ddeliakidis/final-project-whear/README.md

Review Assignment Due Date (https://classroom.github.com/a/-Acvnhrq)

# Final Project

**Team Number:** 4

**Team Name:** Whear

| Team Member Name | Email Address |
| --- | --- |
| jefferson ding | tyding@seas.upenn.edu |
| dimitris deliakidis | ddelias@seas.upenn.edu  |
| carly googel | cagoogel@seas.upenn.edu |

**GitHub Repository URL:** https://github.com/upenn-embedded/final-project-whear

**iOS App Repository:** https://github.com/carlygoogel/Whear

**GitHub Pages Website URL:** [for final submission]\*

## Final Project Proposal

### 1. Abstract

Whear is a smart closet inventory system that tracks which garments are present in your wardrobe in real time. Washable UHF RFID laundry tags are sewn or stuck onto each item, and a YRM100 (Impinj R2000) reader sweeps the closet over a 5–6 dBi UHF patch antenna with a 3–6 m range. The reader is driven by a bare-metal STM32F411RE (Nucleo-64) over UART, which maintains a live presence table with per-tag TTL. On each sweep interval the STM32 framepacks the current tag set over a second UART to an ESP32 Feather HUZZAH32 V2 Wi-Fi bridge, which reconciles the set against a Firestore collection (PATCH for current tags, DELETE for stale ones). A companion iOS app reads the same collection and shows garments as present / missing in real time.

### 2. Motivation

Getting ready shouldn’t be stressful, and yet most people routinely can’t find the garment they want, don’t know whether an item is in the closet, the laundry, or simply misplaced, forget about clothes they haven’t worn in weeks, and end up buying duplicates of pieces they already own. Whear fixes this by making the closet itself aware of its contents: every garment is tagged, the reader continuously reconciles presence/absence, and the app surfaces pieces that have gone missing or haven’t been worn in a long time. The problem is a good fit for an embedded system — it needs always-on scanning, a real UHF RF front end, strict timing for the RFID framing protocol, and a networked bridge to a phone.

### 3. System Block Diagram

```
 ┌─────────────────┐           ┌──────────────────────────────────────────┐
 │ RFID tags on    │  UHF      │ UHF patch antenna (5–6 dBi, SMA)         │
 │ each garment    │◄────────►│                                          │
 │ (96-bit EPC)    │           └────────────────┬─────────────────────────┘
 └─────────────────┘                            │
                                                ▼
                                  ┌──────────────────────┐
                                  │ YRM100 RFID reader   │
                                  │ (Impinj R2000)       │
                                  └──────────┬───────────┘
                                             │ UART1 @ 115200
                                             │ PA9 TX / PA10 RX
                                             ▼
 ┌─────────────────────────────────────────────────────────────────────┐
 │ STM32F411RE (Nucleo-64, bare-metal C)                               │
 │                                                                     │
 │  • YRM100 driver (frame parser, multi-inventory poll)               │
 │  • Tag table: add-on-new, refresh-on-seen, prune after TTL          │
 │  • Debug console → ST-Link VCOM (USART2, PA2/PA3)                   │
 │  • UART frame to ESP32 every SCAN_INTERVAL (USART6, PC6/PC7)        │
 │  • READY-pin handshake on PA8 (input from ESP32)                    │
 └─────────────────────────────────────────┬───────────────────────────┘
                                           │ UART6 @ 115200
                                           │ [0xAA | count | {len,EPC}xN | 0x55]
                                           ▼
 ┌─────────────────────────────────────────────────────────────────────┐
 │ ESP32 Feather HUZZAH32 V2 (Arduino framework)                       │
 │                                                                     │
 │  • UART2 frame reader (GPIO14 RX / GPIO32 TX)                       │
 │  • WiFi.begin → drives READY pin (GPIO27) high when associated      │
 │  • Firestore REST: GET list → DELETE stale → PATCH current          │
 └─────────────────────────────────────────┬───────────────────────────┘
                                           │ HTTPS
                                           ▼
                             ┌─────────────────────────────┐
                             │ Google Firestore            │
                             │  project:    whear-fb2ac    │
                             │  collection: scanner        │
                             └──────────────┬──────────────┘
                                            │
                                            ▼
                             ┌─────────────────────────────┐
                             │ iOS app (SwiftUI)           │
                             │ → live presence dashboard   │
                             └─────────────────────────────┘
```

### 4. Design Sketches

Hand sketches and an Onshape model of the closet-rail enclosure live in the project presentation. The printed enclosure is a closet-rail-mounted box with an integrated hook that hangs directly on the rod, an external SMA antenna, USB power, and standoffs for the Nucleo and ESP32 Feather.

Onshape CAD: https://cad.onshape.com/documents/d4b02aa7ef074eb8d4de5ae9/w/d47a6f38ca1e84162dad2f7c/e/438206de66ef1abd3ba63d5b

### 5. Software Requirements Specification (SRS)

**5.1 Definitions, Abbreviations**

- **EPC** — Electronic Product Code, the 96-bit unique ID broadcast by each UHF RFID tag.
- **RSSI** — Received Signal Strength Indicator, reported in dBm by the reader.
- **TTL** — Time-to-live; how long a tag stays in the "present" set after its last sighting.
- **VCOM** — Virtual COM port exposed by the ST-Link debugger for serial I/O.
- **Firestore** — Google Cloud document database used as the cloud backing store.

**5.2 Functionality**

| ID | Description |
| --- | --- |
| SRS-01 | The STM32 shall drive the YRM100 in continuous multi-inventory mode and add each newly-seen EPC to its presence table within 100 ms of the reader notification. |
| SRS-02 | The STM32 shall de-duplicate EPCs so that the same tag is stored exactly once, and shall track at least 20 concurrent unique tags. |
| SRS-03 | A tag shall be dropped from the presence table if it has not been re-seen within `TAG_TTL_MS` (10 s), so removing a garment from the antenna field is reflected within 10 s. |
| SRS-04 | Every `SCAN_INTERVAL_MS` (5 s) the STM32 shall transmit the current presence set to the ESP32 as a framed UART message (0xAA header, count, {len,EPC}×N, 0x55 footer). |
| SRS-05 | The ESP32 shall associate with the configured Wi-Fi network on boot and drive the READY pin high once Wi-Fi is up, and shall re-associate automatically on disconnect. |
| SRS-06 | On each frame from the STM32 the ESP32 shall reconcile the Firestore `scanner` collection against the received set (PATCH new/present docs, DELETE absent docs). |

### 6. Hardware Requirements Specification (HRS)

**6.1 Definitions, Abbreviations**

- **UHF RFID** — Ultra-High-Frequency (902–928 MHz, US region) passive RFID.
- **YRM100** — UART-based UHF RFID reader module built around the Impinj R2000.
- **Nucleo-F411RE** — ST development board with an STM32F411RE Cortex-M4 and built-in ST-Link/V2-1.
- **ESP32 Feather** — Adafruit Feather HUZZAH32 V2, an ESP32 with USB-C and a 3.3 V regulator.

**6.2 Functionality**

| ID | Description |
| --- | --- |
| HRS-01 | A UHF RFID reader shall detect passive tags on garments at a range of at least 1.5 m (target 3–6 m) using a ≥5 dBi antenna. |
| HRS-02 | The reader shall be configured for the US region (902.25–927.75 MHz) at ≥23 dBm TX power. |
| HRS-03 | A 2.4 GHz 802.11 b/g/n uplink shall carry tag data to Firestore (ESP32 Feather HUZZAH32 V2). |
| HRS-04 | The STM32 and ESP32 shall communicate over a dedicated UART link at 115200 baud, with a GPIO handshake pin for WiFi-ready. |
| HRS-05 | The device shall run from a single 5 V USB supply; each board generates its own 3.3 V rail on-board. |
| HRS-06 | Tag data shall be visible to an end user within 10 s of a garment entering or leaving the antenna field. |

### 7. Bill of Materials (BOM)

| Part | Qty | Purpose |
| --- | --- | --- |
| STM32 Nucleo-F411RE | 1 | Bare-metal MCU running the RFID logic |
| Adafruit Feather HUZZAH32 V2 (ESP32) | 1 | Wi-Fi bridge → Firestore |
| YRM100 UHF RFID reader module | 1 | Impinj R2000, UART-controlled |
| UHF patch antenna, ≥5 dBi, SMA | 1 | Tag interrogation, 3–6 m range |
| Washable UHF RFID laundry tags | 10+ | One per tracked garment |
| 3D-printed enclosure | 1 | Closet-rail mount, antenna + board bay  |
| Jumper wires / headers | — | UART + READY-pin interconnect |
| 5 V USB power supply (2× micro-B / USB-C) | 2 | One per board |

### 8. Final Demo Goals

- Live closet demo: tagged garments placed on / removed from a rack, with the iOS dashboard updating in real time off Firestore.
- At least 10 distinct tags tracked simultaneously with correct presence → absence transitions within 10 s.
- Pull the Wi-Fi / unplug the ESP32 and show the STM32 keep scanning locally; reconnect and show Firestore re-converge.
- The enclosure hangs on an actual closet rail with the antenna oriented down the rod.

### 9. Sprint Planning

| Milestone  | Functionality Achieved | Distribution of Work |
| --- | --- | --- |
| Sprint #1  | YRM100 driver working bare-metal; tags detected, de-duplicated, and logged over serial | Dimitris: YRM100 driver / MCU bring-up · Jefferson: Wi-Fi uplink research · Carly: enclosure + antenna mount + BOM |
| Sprint #2  | Moved to nRF5340 + nRF7002; Zephyr app core + bare-metal net core; IPC ring + WebSocket + iOS app | Dimitris: IPC producer + dedup · Jefferson: Wi-Fi manager + WebSocket client · Carly: iOS app + enclosure + NeoPixel |
| MVP Demo | End-to-end tag → MCU → Wi-Fi bridge → cloud → iOS, with local enclosure mounted on a rail | all |
| Final Demo | Full closet system on STM32 + ESP32 + Firestore, presence + pruning + auto-reconnect, polished case | all |

**This is the end of the Project Proposal section. The remaining sections document our actual progress through the milestone schedule.**

## Repository Layout

```
final-project-whear/
├── makefile            # builds STM32 firmware + delegates ESP32 build to PlatformIO
├── main.c              # STM32F411RE bare-metal app (USARTs, tag table, UART framer)
├── startup.c           # Cortex-M4 vector table + Reset_Handler
├── stm32f411re.ld      # linker script (512 K flash, 128 K RAM)
├── lib/
│   └── yrm100/         # YRM100 driver (frame parser, multi-inventory, region / power)
├── wifi/               # ESP32 PlatformIO project (Arduino framework)
│   ├── platformio.ini
│   ├── include/config.h    # Wi-Fi + Firestore settings
│   └── src/main.cpp        # UART frame reader + Firestore reconciler
├── ios/                # placeholder for the companion iOS app (see carlygoogel/Whear)
└── README.md / README.pdf
```

## Build & Flash

Toolchain: `arm-none-eabi-gcc`, `openocd` (for ST-Link), and PlatformIO (`pio`) on the ESP32 side.

```
make                # build both STM32 firmware and ESP32 project
make main           # build just main.bin
make esp            # build just the ESP32 PlatformIO project
make flash-main     # program STM32 via ST-Link (OpenOCD)
make flash-esp      # upload ESP32 firmware via PlatformIO
make flash          # flash both
make monitor-main   # open ST-Link VCOM @ 115200
make monitor-esp    # open ESP32 serial monitor
make clean          # clean all build artifacts
```

Wi-Fi credentials and Firestore target are compile-time constants in `wifi/include/config.h`:

- `WIFI_SSID`, `WIFI_PASS`
- `FIRESTORE_PROJECT`, `FIRESTORE_COLLECTION`

## Sprint Review #1

### Last week's progress

Our first sprint was all about de-risking the riskiest part of the project: whether we could actually read passive UHF RFID tags through fabric at the range we promised in the proposal. We sourced the full core RFID stack — the YRM100 (Impinj R2000) module, a 6 dBi UHF patch antenna with an SMA pigtail, and a handful of washable laundry tags — and got the reader talking to our MCU over UART. We wrote the first cut of the YRM100 driver from scratch against the manufacturer's frame format (0xBB header, 0x7E terminator, command / response / notice frames with checksum), wired up `start_multi_inventory`, and got continuous tag notifications streaming back with EPC and RSSI. We also stood up a simple dedup table on the MCU so the same tag read twice in a row only fires a "new tag" event once.

### Current state of project

Sourced components for the core RFID system. Have the core RFID system functioning end-to-end: multi-inventory runs continuously, new tags are parsed, de-duplicated, and logged, and we can see clean EPC + RSSI on the serial console. We demoed our key systems working during lab section — a tagged garment held up to the antenna reliably reports its EPC, and walking it out of range cleanly stops the "seen" events.

Demo of our device: https://drive.google.com/file/d/1t3F-Fl3bGAu_fCwf2g--YzYmbsHpy9S0/view?usp=sharing

### Next week's plan

- Build the enclosure (house the reader board, antenna mount, USB power).
- Get Wi-Fi connected and working — this is the other big unknown, since the ATmega route in the original proposal would have bottlenecked on an ESP32 AT-bridge. We're evaluating moving the whole stack to the nRF7002-DK (nRF5340 + nRF7002) so Wi-Fi is first-class and we get a second core for free.
- Source parts for the LCD screen and wire up the display.
- Deploy RFID sensor data to a web endpoint (pick protocol: REST vs. WebSocket).
- Start on mobile interface design and software development.

## Sprint Review #2

We have an iOS app! Check out the repo: https://github.com/carlygoogel/Whear.git. We have also designed and 3D-printed our enclosure; there are some improvements still to make but it's good enough for MVP.

### Last week's progress

Big platform change this sprint: we moved off the ATmega328PB + ESP32 split and onto the nRF7002-DK. The nRF5340 gives us two Cortex-M33s on the same chip, and the nRF7002 gives us a real Wi-Fi 6 radio over QSPI instead of an AT-command bridge, which removes a whole class of latency and buffering problems from the uplink path. We then split the firmware to match the hardware:

- **Network core (bare-metal C):** owns the YRM100 over UARTE0 (P1.04/P1.05), runs continuous multi-inventory, de-duplicates EPCs, and writes new tags into a shared-memory ring buffer. Linker script, startup, and register map were hand-rolled — no Zephyr on this core.
- **Application core (Zephyr RTOS):** configures the SPU to grant the net core access to the RFID UART pins, releases the net core from forced-off, brings up Wi-Fi via the Zephyr `net_mgmt` API with static credentials, waits on a DHCPv4 lease, then opens a WebSocket to the dashboard.
- **IPC:** a 192-byte mailbox pinned at `0x2100FC00` in the top 1 KB of net-core RAM, carrying a magic word, producer/consumer indices, net status, total tag count, and an 8-slot ring of 20-byte tag entries. The net core writes, issues a `__DMB()`, bumps `write_idx`, and fires the nRF5340 IPC `TASKS_SEND[0]`; the app core's ISR gives a semaphore and the main loop drains the ring.

On the uplink side, the WebSocket client formatted each new tag as `{"epc":"<hex>","rssi":<int>}` and sent it as a masked text frame. We added reconnect logic on both the Wi-Fi and WebSocket layers so a dropped AP doesn't brick the pipeline. A top-level Makefile built both cores, flashed each coprocessor separately with `nrfjprog` (`--coprocessor CP_NETWORK` / `CP_APPLICATION`), and opened a serial monitor, so the whole thing was `make flash` from a clean checkout.

### Current state of project

End-to-end tag flow was alive on the nRF5340: tagged garment → antenna → YRM100 → UART → net core driver → IPC ring → app core → WebSocket → dashboard. The enclosure was designed and 3D-printed — a closet-rail-mounted box with an integrated hook that hangs directly on the rod, a window cutout for the display, and internal standoffs for the DK and the antenna. The antenna mounts externally, and the board runs off a single 5 V USB supply.

CAD view: https://cad.onshape.com/documents/d4b02aa7ef074eb8d4de5ae9/w/d47a6f38ca1e84162dad2f7c/e/438206de66ef1abd3ba63d5b

### Next week's plan

- Finish the display driver so the device shows "present / total" counts without needing the phone.
- Build the iOS dashboard against the live stream (presence toggles, last-seen timestamps, forget-me-not list).
- Add a persistence layer on the server so "last seen" survives reader reboots.
- Start measuring: effective read range through fabric, wall-clock latency from tag-waved to dashboard-update, and current draw in idle vs. active scan.

## MVP Demo

**Demo video:** <https://drive.google.com/file/d/1N2IJNhKBomkWYYO8EvbibdFJLx836CyH/view?usp=drivesdk>

**Video:** <https://drive.google.com/file/d/1N2IJNhKBomkWYYO8EvbibdFJLx836CyH/view?usp=drivesdk>

slides link: https://drive.google.com/file/d/1kSxXilXCHxEd3NuJkWGgtv2CBa5h64Ry/view?usp=sharing

app demo link: https://drive.google.com/file/d/1InsEFuI7ygspXl7Fqmm-XXnCJfS2OlbG/view?usp=sharing

**Platform-swap note (important for grading context).** Through Sprint #2 we were building on the nRF5340 + nRF7002 stack (dual-core IPC, WebSocket uplink). Wi-Fi instability on the nRF7002 and long build/flash cycles ate our schedule margin, so right before the demo we re-implemented the datapath on an STM32F411RE + ESP32 Feather HUZZAH32 V2 with Firestore as the cloud layer. The demo video, the shipped firmware in this repo, and the SRS / HRS validation below all describe that final STM32 + ESP32 system.

### System Block Diagram & Hardware Implementation

At MVP we're running two MCUs in a producer / bridge split. The RFID hot path lives on a bare-metal **STM32F411RE** (Nucleo-64, Cortex-M4F @ 16 MHz HSI), and the network path lives on an **ESP32 Feather HUZZAH32 V2** running the Arduino framework. The two are linked by a dedicated UART and a single GPIO handshake line. See *3. System Block Diagram* above for the full data-flow picture — the MVP hardware is exactly that diagram.

- **RFID front end.** A **YRM100** module (Impinj R2000 inside) behind a **6 dBi UHF patch antenna** on an SMA pigtail. Configured at boot for the US band (902.25–927.75 MHz) at 26 dBm via `yrm100_set_region(YRM100_REGION_US)` and `yrm100_set_tx_power(YRM100_POWER_2600)`.
- **STM32 USART map.**
  - **USART1** (PA9 / PA10, AF7) ↔ YRM100 at 115200 baud — the hot RFID link.
  - **USART2** (PA2 / PA3, AF7) → ST-Link VCOM — debug / validation console.
  - **USART6** (PC6 / PC7, AF8) → ESP32 UART2 — framed tag set.
  - **PA8** — input from the ESP32 READY pin; STM32 blocks on this before running inventory.
- **ESP32 pin map.** UART2 RX = GPIO14, UART2 TX = GPIO32, READY output = GPIO27.
- **Power.** Each board takes its own 5 V USB (Nucleo via ST-Link USB, Feather via USB-C) and generates its own 3.3 V rail. No custom PCB — Nucleo + Feather + YRM100 wired with jumpers inside the 3D-printed enclosure.
- **Mechanical.** Closet-rail-mount 3D-printed box with an integrated hook. External SMA antenna, internal standoffs for both boards, cable passthroughs for USB.

### Firmware Implementation

Everything in this repo is hand-written C / C++. No ST HAL, no CubeMX, no vendor example projects on the STM32 side. The ESP32 side sits on top of the Espressif Wi-Fi stack, but the framing protocol and Firestore reconciler are ours.

**STM32 bare-metal runtime (`main.c`, `startup.c`, `stm32f411re.ld`).**

- `startup.c` defines the Cortex-M4 vector table (`.isr_vector`), copies `.data` from flash to RAM, zeros `.bss`, enables the FPU, and jumps to `main`.
- `stm32f411re.ld` places `.isr_vector` / `.text` / `.rodata` in flash (512 K @ `0x08000000`) and `.data` / `.bss` in RAM (128 K @ `0x20000000`), with `_estack` at the top of RAM.
- `clock_init()` stays on the 16 MHz HSI (reset default), enables GPIOA/B/C on AHB1, USART2 on APB1, USART1 + USART6 on APB2, and programs SysTick for 1 ms ticks.
- `gpio_init()` configures each UART pin for alternate-function mode and sets pull-ups on the RX lines so a disconnected bus idles high.

**Application logic (`main.c` main loop).**

1. Bring up clocks, GPIO, USART2 (debug), USART6 (ESP32).
2. Block on `esp_ready()` (PA8) until the ESP32 signals it has joined Wi-Fi.
3. Initialize the YRM100, set region + TX power, and dump raw bytes on the RFID UART for 2 s as a sanity check (`[diag] raw RX window`).
4. Call `yrm100_start_multi_inventory(&rfid, 0xFFFF)` — the reader now streams notices on its own.
5. Loop forever calling `yrm100_poll_inventory`:
   - On `YRM100_OK`, run `find_or_add_tag`: linear-search the 20-slot `seen_tags` table, update `tag_last_seen` on a hit, append on a miss, print `[NEW] EPC: … RSSI: … dBm` for first sightings.
   - On `YRM100_ERR_TIMEOUT`, bump a counter; on other errors, bump the error counter.
6. Every `SCAN_INTERVAL_MS` (5 s) dump the poll counters, call `prune_stale_tags()` to drop any EPC not re-seen within `TAG_TTL_MS` (10 s), then — if `esp_ready()` is still high — call `esp_send_tags()` to frame the current set to the ESP32.

**Critical driver — YRM100 (`lib/yrm100/yrm100.{c,h}`).** Written from scratch against the Impinj manual. Frame layout is `0xBB | type | CMD | len_hi | len_lo | payload… | checksum | 0x7E` with three frame types (command, response, notice). The driver exposes a callback-based UART interface (`uart_init`, `uart_send`, `uart_recv_byte`, `uart_data_available`), a byte-by-byte parser with checksum validation, and high-level calls for `SET_REGION`, `SET_TX_POWER`, `START_MULTI_INVENTORY`, `STOP_INVENTORY`, `READ`, `WRITE`. `yrm100_poll_inventory` pulls notices out of the stream and hands back a struct carrying the EPC bytes, length, and signed RSSI in dBm.

**Critical driver — STM32↔ESP32 framer (`esp_send_tags` / `read_frame`).** Deliberately simple and self-resyncing: `0xAA | count | {len, EPC[len]}×count | 0x55`. Start marker is searched for with no overall timeout (idle state); after that every byte has a 500 ms per-byte timeout. A malformed frame just returns `-1` and the reader goes back to hunting for `0xAA`. The **READY pin** is the out-of-band signal that lets the STM32 know the ESP32 is alive and on Wi-Fi before sending frames.

**Critical driver — Firestore reconciler (`wifi/src/main.cpp`).** On each frame from the STM32, `firestore_full_replace` does:

1. `GET /v1/projects/whear-fb2ac/databases/(default)/documents/scanner` → parse the doc list with ArduinoJson.
2. For every existing doc ID not in the current tag set, issue `DELETE` on that doc.
3. For every tag in the current set, issue `PATCH` on its doc ID with `{"fields": {"id": {"stringValue": "<epc>"}}}` (PATCH upserts — creates the doc if missing).

No service-account auth is needed because the demo collection is open read/write; the iOS app reads the same collection.

### Demo

The clip walks through the STM32 + ESP32 + Firestore stack end-to-end:

1. Power on → ST-Link VCOM boots; STM32 prints `=== Whear STM32 RFID Scanner ===` and `Waiting for ESP32 READY...`.
2. ESP32 joins Wi-Fi, drives READY high → STM32 runs `set_region` + `set_tx_power`, then `Starting multi-inventory...`.
3. Tagged garments in the antenna field → `[NEW] EPC: … RSSI: … dBm` on the debug UART.
4. Every 5 s: `[poll] ok=N to=N err=N` counters, then `[UART] sending N tags` → ESP32 logs `[uart] received N tags` and one `[firestore] PATCH <epc> → 200` per tag.
5. Remove a garment → after the 10 s TTL, STM32 logs `[stale] EPC: …` → ESP32 logs `[firestore] DELETE <epc> → 200` → iOS app removes the row.
6. Re-add the garment → reappears on the iOS dashboard on the next 5 s cycle.
7. Pull Wi-Fi on the ESP32 → READY drops low → STM32 keeps scanning locally, no uploads. Restore Wi-Fi → ESP32 auto-reconnects, READY goes high, Firestore re-converges on the next cycle.

### SRS Validation & Data Collection

**How we collected data.** Two serial consoles running simultaneously: `make monitor-main` tails the STM32 ST-Link VCOM and prints every `[NEW]`, `[stale]`, `[poll]`, and `[UART]` line; `make monitor-esp` tails the ESP32 and prints `[uart] received N tags` plus one `[firestore] PATCH/DELETE … → <HTTP code>` per document op. Cross-checked against the live Firestore console in a browser and the iOS app in parallel. End-to-end latency was stopwatch-timed from waving a tag in / out of range to the iOS row appearing / disappearing.

| ID | Requirement | Achieved? | Evidence |
| --- | --- | --- | --- |
| SRS-01 | New EPC into presence table within 100 ms | Yes | `[NEW]` prints on the debug UART within one poll cycle of the YRM100 notice; the poll loop has no blocking calls other than a short-timeout `uart_recv_byte`. |
| SRS-02 | De-duplicate EPCs, track ≥ 20 concurrent tags | Yes | `find_or_add_tag` indexes into `seen_tags[MAX_TAGS=20]` and only prints `[NEW]` on first sighting; re-waving the same tag does not re-print. |
| SRS-03 | Drop tags not re-seen within 10 s | Yes | `prune_stale_tags` logs `[stale] EPC: …` ~10 s after a garment leaves the field; stopwatch-verified. |
| SRS-04 | Frame the set to ESP32 every 5 s | Yes | `[UART] sending N tags` cadence matches `SCAN_INTERVAL_MS`; ESP32 logs `[uart] received N tags` on each frame. |
| SRS-05 | ESP32 associates with Wi-Fi on boot, auto-reconnects | Yes | Unplugging the AP drops READY low within one loop iteration; on restore, ESP32 prints `WiFi reconnected` and drives READY high again. |
| SRS-06 | Firestore reconciliation (PATCH present, DELETE stale) | Yes | `[firestore] PATCH … → 200` per present tag and `DELETE … → 200` per stale tag; Firestore console tracks the physical rack. |

### HRS Validation & Data Collection

**How we collected data.** Read range was measured with a tape measure, a hanging shirt with a washable laundry tag, and the iOS app as ground truth — we walked the tag away from the antenna until the row disappeared and noted the distance. Region / TX power were verified by `YRM100_OK` return codes on `set_*` + read-back via the matching `get_*`. The UART link between the boards was sniffed on a logic analyzer at 115200 to confirm framing. Power was confirmed with a USB power meter on each board's cable.

| ID | Requirement | Achieved? | Evidence |
| --- | --- | --- | --- |
| HRS-01 | UHF RFID read range ≥ 1.5 m through fabric (target 3–6 m)  | Threshold yes, target partial | Reliable reads past 1.5 m on hanging garments with the 6 dBi patch. Past ~3 m the read rate drops off depending on tag orientation — inside a closet but short of 6 m. |
| HRS-02 | Reader in US region at ≥ 23 dBm | Yes | `yrm100_set_region(REGION_US)` + `yrm100_set_tx_power(POWER_2600)` (26 dBm) return `OK`; confirmed by `get_*` read-back. |
| HRS-03 | 2.4 GHz 802.11 b/g/n uplink | Yes | ESP32 Feather associates with the configured SSID and pushes HTTPS to Firestore. |
| HRS-04 | STM32↔ESP32 UART + GPIO ready handshake | Yes | USART6 @ 115200 on PC6/PC7 ↔ ESP32 UART2 on GPIO14/GPIO32; PA8 ← GPIO27 verified with a logic probe. |
| HRS-05 | Single 5 V USB per board, each board's own 3.3 V rail | Yes | Nucleo runs off ST-Link USB, Feather off USB-C; both provide their own 3.3 V. |
| HRS-06 | End-to-end presence change visible ≤ 10 s | Yes | 5 s scan + 10 s TTL + sub-second Firestore round-trip → worst-case visibility inside ~10 s (stopwatch-timed). |

###  Remaining Elements That Make The Project Whole

- **Mechanical / casework.** The 3D-printed closet-rail enclosure is printed and the boards fit inside, but the antenna mounts externally with tape for now — we want a snap-in SMA mount and proper strain relief on the USB pass-throughs. Hook geometry works on a standard closet rod; a second rev would add damping so it doesn't swing on install.
- **iOS app (`carlygoogel/Whear`).** SwiftUI app reading the live Firestore `scanner` collection, showing garments as present / missing. Still TODO: per-garment user-assigned labels per EPC, a `lastSeen` timestamp field (needs the ESP32 to write it), and a "forget-me-not" view for garments that haven't appeared in a long time.
- **Web portal.** Not built yet. Leaning toward a tiny Firebase-hosted SPA that shares the same Firestore read path as the iOS app so we don't duplicate backend logic. For the demo the Firestore console doubles as a web portal.
- **On-device UX.** No local TFT / NeoPixel on the STM32 path yet (those were scaffolded for the nRF build). Minimum useful add is a status LED on a free STM32 GPIO blinking on each successful UART frame to the ESP32 — cheap confidence signal during demos.
- **Persistence across reboots.** Firestore stores the current set; a separate `history` subcollection would let us recover "last seen" after a power cycle.

###  Riskiest Remaining Part

The riskiest single piece is the **Firestore REST reconciliation loop**. Each 5 s cycle does 1 × GET + up to N × (PATCH or DELETE) as separate HTTPS calls. Any one of them can fail with a 429 (rate limit), a TLS glitch on a flaky AP, or a socket timeout, and right now a failure on the GET step skips the DELETE pass for that cycle — meaning a removed garment can linger on the iOS app for an extra cycle. We also only have 20 tag slots in `MAX_TAGS`; a realistic closet is 50+, and overflowing silently drops tags.

Secondary risks:

- **Wi-Fi captive portals / enterprise auth.** The demo AP accepts a static PSK, but a WPA2-Enterprise closet Wi-Fi would need a different association path on the ESP32.
- **RFID read reliability at depth.** Dense garments stacked parallel to the antenna can detune a tag; the 6 dBi patch helps but doesn't fully solve it.
- **Single-point-of-failure framer.** If the ESP32 reboots mid-frame, the STM32 keeps sending and the ESP32 spends one cycle resyncing on `0xAA` — harmless, but worth documenting.

###  De-risking Plan

- **Batch the Firestore writes.** Switch from N HTTP calls per cycle to a single `documents:commit` with a batched write list. One TLS handshake per cycle, one HTTP status to check. If `commit` is rejected, retry the whole batch on the next cycle instead of letting partial state linger.
- **Grow the tag table and harden the lookup.** Bump `MAX_TAGS` to 128 (plenty of RAM on the F411RE), move `seen_tags` to a small open-addressing hash keyed on EPC prefix, and add a `dropped_tags` counter so a full table logs a warning instead of silently failing.
- **CRC on the STM32↔ESP32 frame.** Append CRC-16 before `0x55`. A bad CRC means resync on the next `0xAA` — turns "mostly works" into "provably recovers from any single-byte glitch on the UART line."
- **Retry + backoff on the ESP32.** Short retry on 5xx / socket errors, exponential backoff on repeated 4xx so we don't hammer Firestore during an outage.
- **Idle power.** Move the STM32 into Stop mode between scan cycles with a SysTick wake — the RFID sweep is only a few hundred ms, so most of the 5 s window can be spent asleep. Cuts idle current by ~10× for a future battery-powered revision.
- **Validation coverage.** Add a `scripted_test` mode that simulates `[NEW]` / `[stale]` events on a timer so we can rerun SRS-03 / SRS-04 / SRS-06 without a physical closet in front of us.

###  Questions / Help Needed From The Teaching Team

- **Cloud layer acceptance.** Is Firestore (HTTPS REST from the ESP32) acceptable as the "networked bridge" for the grading rubric, or do you prefer a self-hosted WebSocket / MQTT broker for the final demo? If WebSocket is required, we'd like guidance on where the broker should run (lab Wi-Fi vs. a teammate's laptop).
- **Scope of the "MCU on network" requirement.** Our STM32 is not directly on Wi-Fi — it reaches the network through the ESP32 bridge. Does that satisfy the networking portion of the project, or does the primary MCU itself need an IP stack? If the latter, we'd rather know now so we can put Wi-Fi on the STM32 side (e.g. an ESP-AT shield) rather than rework later.
- **RFID range measurement.** Is there a preferred teaching-team method (reference tag, distance protocol, anechoic-chamber slot) for measuring UHF RFID read range, so HRS-01 validation uses the same yardstick as past teams?
- **Documentation of the platform swap.** Should the final report cover both the nRF5340 + nRF7002 work (which we sank real design effort into) and the shipped STM32 + ESP32 system, or only the shipped system? We have a clean write-up of the nRF path but don't want to pad the report.
- **Demo logistics.** How much of the demo needs to run off the actual closet rail vs. on the bench? Our enclosure hangs on a rod, but the rod has to be somewhere in the demo space.

- 3D-printed closet-rail enclosure with external  https://drive.google.com/file/d/1J_ec6Xb1JYiLGLx2zHbNruXg-LhrsJuC/view?usp=sharing
- STM32 + Feather HUZZAH32 V2 wired  https://drive.google.com/file/d/1gzVkoXcbBsCQWo_pEb8pmvoGvABsOyvP/view?usp=sharing

Onshape CAD: https://cad.onshape.com/documents/d4b02aa7ef074eb8d4de5ae9/w/d47a6f38ca1e84162dad2f7c/e/438206de66ef1abd3ba63d5b

## Final Report

Don't forget to make the GitHub pages public website! If you've never made a GitHub pages website before, you can follow this webpage (though, substitute your final project repository for the GitHub username one in the quickstart guide): [https://docs.github.com/en/pages/quickstart](https://docs.github.com/en/pages/quickstart)

### 1. Video

### 2. Images

### 3. Results

#### 3.1 Software Requirements Specification (SRS) Results

| ID | Description | Validation Outcome |
| --- | --- | --- |
| SRS-01 | YRM100 multi-inventory, new EPC into presence table within 100 ms. | Confirmed; `yrm100_poll_inventory` runs in the main loop and `[NEW]` lines print on the debug UART as soon as the notice arrives. |
| SRS-02 | De-duplicate EPCs and track ≥20 concurrent tags. | Confirmed; `find_or_add_tag` indexes into `seen_tags[MAX_TAGS=20]` and refreshes `tag_last_seen` on re-sightings. |
| SRS-03 | Drop tags not re-seen within 10 s. | Confirmed; `prune_stale_tags` runs every send cycle and logs `[stale]` for each removed EPC. |
| SRS-04 | Frame current set to ESP32 every 5 s with `0xAA \| count \| {len,EPC}×N \| 0x55`. | Confirmed; `esp_send_tags` over USART6 at 115200; ESP32 logs `[uart] received N tags`. |
| SRS-05 | ESP32 associates with Wi-Fi on boot, drives READY high, auto-reconnects. | Confirmed; `PIN_READY` (GPIO27) goes HIGH after `WL_CONNECTED`; loop calls `WiFi.reconnect()` and holds READY low while down. |
| SRS-06 | Firestore reconciliation on each frame (PATCH present, DELETE stale). | Confirmed; `firestore_full_replace` GETs the collection, DELETEs missing doc IDs, PATCHes current ones; iOS reflects the changes. |

#### 3.2 Hardware Requirements Specification (HRS) Results

| ID | Description | Validation Outcome |
| --- | --- | --- |
| HRS-01 | UHF RFID read range ≥1.5 m through fabric with ≥5 dBi antenna. | Confirmed in lab; laundry tags on hanging garments detected well past 1.5 m with the 6 dBi patch antenna. |
| HRS-02 | Reader configured for US region at ≥23 dBm. | Confirmed; `yrm100_set_region(YRM100_REGION_US)` + `yrm100_set_tx_power(YRM100_POWER_2600)` (26 dBm) at boot. |
| HRS-03 | 2.4 GHz Wi-Fi b/g/n uplink. | Confirmed; ESP32 associates with the configured SSID and pushes HTTPS to Firestore. |
| HRS-04 | STM32 ↔ ESP32 UART at 115200 with GPIO ready handshake. | Confirmed; USART6 on PC6/PC7 ↔ ESP32 UART2 on GPIO14/GPIO32, plus PA8 ← GPIO27 READY pin. |
| HRS-05 | Single 5 V USB supply per board; each board's own 3.3 V rail.  | Confirmed; Nucleo runs off ST-Link USB, Feather runs off USB-C, both provide their own 3.3 V. |
| HRS-06 | End-to-end presence change visible within 10 s. | Confirmed; 5 s scan interval + 10 s TTL + sub-second Firestore round-trip put worst-case visibility inside ~10 s. |

### 4. Conclusion

Whear shipped as a working closet-inventory system: laundry-tagged garments are seen by a YRM100 over a 6 dBi patch antenna, tracked in a TTL-based presence table on a bare-metal STM32F411RE, framed over UART to an ESP32 Feather that reconciles the set against Firestore, and surfaced in a SwiftUI iOS app. The core embedded contribution was the hand-written YRM100 driver (frame parser, multi-inventory state machine, region / power configuration) and the STM32 bare-metal runtime around it — clock init, three USARTs, SysTick-based timing, and the deterministic framer on the ESP32 link. The biggest lesson was one of platform risk: the nRF5340 + nRF7002 path we developed through Sprint #2 was architecturally nicer (dual-core IPC, direct WebSocket uplink) but was not stable enough in the demo window, and rebuilding on the STM32 + ESP32 layout — which we knew cold from prior labs — was the right call even though it meant re-writing the firmware at the last moment.

## References

- YRM100 / Impinj R2000 module datasheet and frame-format manual
- STM32F411RE reference manual (RM0383) and datasheet
- Espressif ESP32 Arduino core (`WiFi.h`, `HTTPClient.h`, `WiFiClientSecure.h`)
- Google Firestore REST API (documents:list / PATCH / DELETE)

# Notes

**STM32F411RE pin map**

- USART1 — YRM100 reader: PA9 (TX), PA10 (RX)
- USART2 — ST-Link VCOM debug: PA2 (TX), PA3 (RX)
- USART6 — ESP32 bridge: PC6 (TX), PC7 (RX)
- PA8 — READY input from ESP32 (pulled down; ESP32 drives high when Wi-Fi is up)

**ESP32 Feather HUZZAH32 V2 pin map**

- UART2 RX: GPIO14 (← STM32 PC6)
- UART2 TX: GPIO32 (→ STM32 PC7)
- READY out: GPIO27 (→ STM32 PA8)

**Legacy (nRF5340) UART pins, kept for reference**

- TX (nRF → YRM100 RX): P1.04
- RX (nRF ← YRM100 TX): P1.05
