ddeliakidis/final-project-whear/main.c

/* Whear — STM32F411RE bare-metal firmware
 *
 *   USART1  →  YRM100 RFID        (PA9 TX, PA10 RX)
 *   USART2  →  Debug via ST-Link VCOM  (PA2 TX, PA3 RX)
 *   USART6  →  ESP32 bridge        (PC6 TX, PC7 RX)
 *   SPI1    →  ST7735 1.8" TFT    (PA5 SCK, PA7 MOSI, PB0 DC, PB1 RST, PB2 CS)
 *   GPIO    →  READY pin (PA8, input from ESP32)
 */

#include <stdint.h>
#include <string.h>
#include "lib/yrm100/yrm100.h"
#include "lib/display/st7735.h"
#include "lib/display/lcd_gfx.h"

/* ── Minimal STM32F411RE register map ────────────────────────────── */

typedef struct {
    volatile uint32_t CR, PLLCFGR, CFGR, CIR, AHB1RSTR, AHB2RSTR;
    uint32_t _pad1[2];
    volatile uint32_t APB1RSTR, APB2RSTR;
    uint32_t _pad2[2];
    volatile uint32_t AHB1ENR, AHB2ENR;
    uint32_t _pad3[2];
    volatile uint32_t APB1ENR, APB2ENR;
} RCC_t;
#define RCC ((RCC_t *)0x40023800)

typedef struct {
    volatile uint32_t MODER, OTYPER, OSPEEDR, PUPDR, IDR, ODR, BSRR, LCKR;
    volatile uint32_t AFR[2];
} GPIO_t;
#define GPIOA ((GPIO_t *)0x40020000)
#define GPIOB ((GPIO_t *)0x40020400)
#define GPIOC ((GPIO_t *)0x40020800)

typedef struct {
    volatile uint32_t SR, DR, BRR, CR1, CR2, CR3, GTPR;
} USART_t;
#define USART1 ((USART_t *)0x40011000)
#define USART2 ((USART_t *)0x40004400)
#define USART6 ((USART_t *)0x40011400)

typedef struct {
    volatile uint32_t CTRL, LOAD, VAL, CALIB;
} SYSTICK_t;
#define SYSTICK ((SYSTICK_t *)0xE000E010)

/* Bit defines */
#define USART_SR_TXE  (1 << 7)
#define USART_SR_TC   (1 << 6)
#define USART_SR_RXNE (1 << 5)
#define USART_CR1_UE  (1 << 13)
#define USART_CR1_TE  (1 << 3)
#define USART_CR1_RE  (1 << 2)

/* ── Config ──────────────────────────────────────────────────────── */
#define HSI_FREQ         16000000UL
#define SCAN_INTERVAL_MS 5000       /* Firestore update cadence */
#define TAG_TTL_MS       10000      /* drop a tag if not re-seen within this */
#define MAX_TAGS         20
#define UART_BAUD        115200
#define USARTDIV_115200  0x008B   /* 16MHz / (16 * 115200) ≈ 8.68 → Mant=8, Frac=11 */

/* ── SysTick millisecond timer ──────────────────────────────────── */

static volatile uint32_t ms_ticks;

void SysTick_Handler(void) { ms_ticks++; }

static uint32_t millis(void) { return ms_ticks; }

static void delay_ms(uint32_t ms) {
    uint32_t start = ms_ticks;
    while ((ms_ticks - start) < ms);
}

/* ── Clock / peripheral enable ──────────────────────────────────── */

static void clock_init(void) {
    /* HSI @ 16 MHz is the reset default — nothing to change */

    /* GPIOA, GPIOB, GPIOC */
    RCC->AHB1ENR  |= (1 << 0) | (1 << 1) | (1 << 2);
    /* USART2 (APB1) */
    RCC->APB1ENR  |= (1 << 17);
    /* USART1 (bit 4), USART6 (bit 5) on APB2 */
    RCC->APB2ENR  |= (1 << 4) | (1 << 5);

    /* SysTick: 1ms @ 16MHz */
    SYSTICK->LOAD = HSI_FREQ / 1000 - 1;
    SYSTICK->VAL  = 0;
    SYSTICK->CTRL = 0x7;   /* CPU clock, interrupt, enable */
}

/* ── GPIO configuration ─────────────────────────────────────────── */

static void gpio_set_af(GPIO_t *port, uint32_t pin, uint32_t af) {
    port->MODER &= ~(3u << (pin * 2));
    port->MODER |=  (2u << (pin * 2));
    uint32_t idx = pin / 8;
    uint32_t shift = (pin % 8) * 4;
    port->AFR[idx] &= ~(0xFu << shift);
    port->AFR[idx] |=  (af   << shift);
}

static void gpio_init(void) {
    /* USART2 TX/RX on PA2/PA3 (AF7) — ST-Link VCOM */
    gpio_set_af(GPIOA, 2, 7);
    gpio_set_af(GPIOA, 3, 7);

    /* USART1 TX/RX on PA9/PA10 (AF7) — YRM100 */
    gpio_set_af(GPIOA, 9, 7);
    gpio_set_af(GPIOA, 10, 7);
    /* PA10 (RX) pull-up so it idles high if line is flaky */
    GPIOA->PUPDR &= ~(3u << (10*2));
    GPIOA->PUPDR |=  (1u << (10*2));

    /* USART6 TX/RX on PC6/PC7 (AF8) — ESP32 bridge */
    gpio_set_af(GPIOC, 6, 8);
    gpio_set_af(GPIOC, 7, 8);
    /* PC7 (RX) pull-up */
    GPIOC->PUPDR &= ~(3u << (7*2));
    GPIOC->PUPDR |=  (1u << (7*2));

    /* PA8 as READY input with pull-down */
    GPIOA->MODER &= ~(3u << (8*2));
    GPIOA->PUPDR &= ~(3u << (8*2));
    GPIOA->PUPDR |=  (2u << (8*2));
}

/* ── USART2 (debug output via ST-Link VCOM) ─────────────────────── */

static void usart2_init(void) {
    USART2->BRR = USARTDIV_115200;
    USART2->CR1 = USART_CR1_UE | USART_CR1_TE | USART_CR1_RE;
}

static void dbg_putc(char c) {
    while (!(USART2->SR & USART_SR_TXE));
    USART2->DR = (uint8_t)c;
}

static void dbg_puts(const char *s) {
    while (*s) dbg_putc(*s++);
}

static void dbg_print_hex(uint8_t b) {
    static const char hex[] = "0123456789ABCDEF";
    dbg_putc(hex[b >> 4]);
    dbg_putc(hex[b & 0x0F]);
}

static void dbg_print_u8(uint8_t v) {
    if (v >= 100) dbg_putc('0' + v / 100);
    if (v >= 10)  dbg_putc('0' + (v / 10) % 10);
    dbg_putc('0' + v % 10);
}

/* ── USART1 callbacks for YRM100 ────────────────────────────────── */

static void yrm_uart_init(uint32_t baud) {
    (void)baud;
    USART1->BRR = USARTDIV_115200;
    USART1->CR1 = USART_CR1_UE | USART_CR1_TE | USART_CR1_RE;
}

static void yrm_uart_send(const uint8_t *data, uint16_t len) {
    for (uint16_t i = 0; i < len; i++) {
        while (!(USART1->SR & USART_SR_TXE));
        USART1->DR = data[i];
    }
    while (!(USART1->SR & USART_SR_TC));
}

static uint8_t yrm_uart_recv_byte(uint16_t timeout_ms) {
    uint32_t start = millis();
    while ((millis() - start) < timeout_ms) {
        if (USART1->SR & USART_SR_RXNE) return (uint8_t)USART1->DR;
    }
    return 0;
}

static uint8_t yrm_uart_data_available(void) {
    return (USART1->SR & USART_SR_RXNE) ? 1 : 0;
}

/* ── USART6 (to ESP32) ──────────────────────────────────────────── */

static void esp_uart_init(void) {
    USART6->BRR = USARTDIV_115200;
    USART6->CR1 = USART_CR1_UE | USART_CR1_TE | USART_CR1_RE;
}

static void esp_uart_send_byte(uint8_t b) {
    while (!(USART6->SR & USART_SR_TXE));
    USART6->DR = b;
}

static void esp_send_tags(const yrm100_tag_t *tags, uint8_t count) {
    esp_uart_send_byte(0xAA);           /* start marker */
    esp_uart_send_byte(count);
    for (uint8_t i = 0; i < count; i++) {
        esp_uart_send_byte(tags[i].epc_len);
        for (uint8_t j = 0; j < tags[i].epc_len; j++)
            esp_uart_send_byte(tags[i].epc[j]);
    }
    esp_uart_send_byte(0x55);           /* end marker */
    while (!(USART6->SR & USART_SR_TC));
}

/* ── ESP32 READY pin ────────────────────────────────────────────── */

static uint8_t esp_ready(void) {
    return (GPIOA->IDR & (1u << 8)) ? 1 : 0;
}

/* ── Tag tracking with TTL ───────────────────────────────────────── */

static yrm100_tag_t seen_tags[MAX_TAGS];
static uint32_t     tag_last_seen[MAX_TAGS];   /* ms timestamp of last scan */
static uint8_t      num_tags;

static void print_tag(const yrm100_tag_t *tag);   /* fwd decl */

static uint8_t find_or_add_tag(const yrm100_tag_t *tag) {
    uint32_t now = millis();
    for (uint8_t i = 0; i < num_tags; i++) {
        if (seen_tags[i].epc_len == tag->epc_len &&
            memcmp(seen_tags[i].epc, tag->epc, tag->epc_len) == 0) {
            seen_tags[i].rssi = tag->rssi;
            tag_last_seen[i]  = now;
            return 0;
        }
    }
    if (num_tags < MAX_TAGS) {
        memcpy(&seen_tags[num_tags], tag, sizeof(*tag));
        tag_last_seen[num_tags] = now;
        num_tags++;
    }
    return 1;
}

/* Remove tags that haven't been re-scanned within TAG_TTL_MS */
static void prune_stale_tags(void) {
    uint32_t now = millis();
    uint8_t  write = 0;
    for (uint8_t read = 0; read < num_tags; read++) {
        if ((now - tag_last_seen[read]) < TAG_TTL_MS) {
            if (write != read) {
                seen_tags[write]     = seen_tags[read];
                tag_last_seen[write] = tag_last_seen[read];
            }
            write++;
        } else {
            dbg_puts("[stale] ");
            print_tag(&seen_tags[read]);
        }
    }
    num_tags = write;
}

/* ── Display helpers ────────────────────────────────────────────── */

static char *u8_to_str(uint8_t v, char *p) {
    if (v >= 100) *p++ = '0' + v / 100;
    if (v >= 10)  *p++ = '0' + (v / 10) % 10;
    *p++ = '0' + v % 10;
    return p;
}

static char *byte_to_hex(uint8_t b, char *p) {
    static const char hex[] = "0123456789ABCDEF";
    *p++ = hex[b >> 4];
    *p++ = hex[b & 0x0F];
    return p;
}

static void display_update(uint8_t tag_count, const yrm100_tag_t *last_tag) {
    char line[32];
    char *p;

    LCD_drawBlock(0, 0, LCD_WIDTH - 1, 47, BLACK);

    LCD_drawString(4, 4, "Whear RFID", CYAN, BLACK);

    p = line;
    const char *prefix = "Tags: ";
    while (*prefix) *p++ = *prefix++;
    p = u8_to_str(tag_count, p);
    *p = '\0';
    LCD_drawString(4, 20, line, WHITE, BLACK);

    if (last_tag && last_tag->epc_len > 0) {
        p = line;
        uint8_t show = last_tag->epc_len > 6 ? 6 : last_tag->epc_len;
        for (uint8_t i = 0; i < show; i++) p = byte_to_hex(last_tag->epc[i], p);
        *p = '\0';
        LCD_drawString(4, 36, line, YELLOW, BLACK);
    }
}

static void print_tag(const yrm100_tag_t *tag) {
    dbg_puts("EPC: ");
    for (uint8_t i = 0; i < tag->epc_len; i++) {
        dbg_print_hex(tag->epc[i]);
        if (i < tag->epc_len - 1) dbg_putc(' ');
    }
    dbg_puts("  RSSI: ");
    if (tag->rssi < 0) {
        dbg_putc('-');
        dbg_print_u8((uint8_t)(-tag->rssi));
    } else {
        dbg_print_u8((uint8_t)tag->rssi);
    }
    dbg_puts(" dBm\r\n");
}

/* ── Main ────────────────────────────────────────────────────────── */

int main(void) {
    clock_init();
    gpio_init();
    usart2_init();
    esp_uart_init();

    lcd_init();
    LCD_setScreen(BLACK);
    LCD_drawString(4, 4,  "Whear RFID", CYAN, BLACK);
    LCD_drawString(4, 20, "booting...",  WHITE, BLACK);

    dbg_puts("\r\n=== Whear STM32 RFID Scanner ===\r\n");
    dbg_puts("Waiting for ESP32 READY...\r\n");

    while (!esp_ready()) delay_ms(100);
    dbg_puts("ESP32 ready\r\n");

    /* YRM100 setup */
    yrm100_t rfid;
    const yrm100_uart_t uart_cb = {
        .uart_init           = yrm_uart_init,
        .uart_send           = yrm_uart_send,
        .uart_recv_byte      = yrm_uart_recv_byte,
        .uart_data_available = yrm_uart_data_available,
    };
    yrm100_init(&rfid, &uart_cb, UART_BAUD);
    delay_ms(500);

    /* Raw RX diagnostic: 2s window, dump any byte that arrives on USART1.
       This tells us if PA10 is wired correctly before we run any protocol. */
    dbg_puts("[diag] raw RX window (2s)...\r\n");
    {
        uint32_t t0 = millis();
        uint32_t got = 0;
        while ((millis() - t0) < 2000) {
            if (USART1->SR & USART_SR_RXNE) {
                uint8_t b = (uint8_t)USART1->DR;
                dbg_print_hex(b);
                dbg_putc(' ');
                got++;
            }
        }
        dbg_puts("\r\n[diag] got "); dbg_print_u8(got > 255 ? 255 : got);
        dbg_puts(" bytes\r\n");
    }

    yrm100_status_t s;
    s = yrm100_set_region(&rfid, YRM100_REGION_US);
    dbg_puts("set_region: "); dbg_print_u8(s); dbg_puts("\r\n");

    s = yrm100_set_tx_power(&rfid, YRM100_POWER_2600);
    dbg_puts("set_tx_power: "); dbg_print_u8(s); dbg_puts("\r\n");

    dbg_puts("Starting multi-inventory...\r\n\r\n");
    yrm100_start_multi_inventory(&rfid, 0xFFFF);

    uint32_t last_send = millis();
    uint32_t poll_ok = 0, poll_timeout = 0, poll_err = 0;

    while (1) {
        yrm100_tag_t tag;
        s = yrm100_poll_inventory(&rfid, &tag);

        if (s == YRM100_OK) {
            poll_ok++;
            if (find_or_add_tag(&tag)) {
                dbg_puts("[NEW] ");
                print_tag(&tag);
            }
        } else if (s == YRM100_ERR_TIMEOUT) {
            poll_timeout++;
        } else {
            poll_err++;
        }

        if ((millis() - last_send) >= SCAN_INTERVAL_MS) {
            dbg_puts("[poll] ok=");  dbg_print_u8(poll_ok > 255 ? 255 : poll_ok);
            dbg_puts(" to=");        dbg_print_u8(poll_timeout > 255 ? 255 : poll_timeout);
            dbg_puts(" err=");       dbg_print_u8(poll_err > 255 ? 255 : poll_err);
            dbg_puts("\r\n");
            poll_ok = poll_timeout = poll_err = 0;

            /* Drop tags that haven't been re-scanned recently */
            prune_stale_tags();

            if (esp_ready()) {
                dbg_puts("[UART] sending ");
                dbg_print_u8(num_tags);
                dbg_puts(" tags\r\n");
                esp_send_tags(seen_tags, num_tags);
            }

            display_update(num_tags, num_tags > 0 ? &seen_tags[num_tags - 1] : 0);

            last_send = millis();
            /* tags persist; prune_stale_tags() removes them when TTL expires.
               Inventory keeps running from the initial 0xFFFF rounds. */
        }
    }
}
