ddeliakidis/final-project-whear/wifi/include/config.h

#ifndef CONFIG_H
#define CONFIG_H

/* Fill in your WiFi credentials before building */
#define WIFI_SSID "AirPennNet-Device"
#define WIFI_PASS "penn1740wifi"


/* Firestore project */
#define FIRESTORE_PROJECT    "whear-fb2ac"
#define FIRESTORE_COLLECTION "scanner"

#endif /* CONFIG_H */
